driesenj/drum-machine-sequencer/README.md

# STM32 Drum Sequencer

A 15-channel hardware step sequencer built around the STM32L476RG microcontroller. Designed for use with modular synthesizers or any gear that accepts gate signals. Features per-channel gate outputs, two pattern banks, live and commit editing modes, swing, randomisation, ratchet, and save/load to onboard flash.

---

## Features

- **15 independent gate output channels** at approximately 5V, each protected by a 1kΩ output resistor
- **8-step view window** with scrollable view across patterns up to 64 steps long
- **Two pattern banks (A/B)** per channel for quick pattern switching
- **Live mode and commit mode** — edit patterns live or stage changes and commit them all at once
- **Per-channel and global swing** (0–100%, triplet feel at maximum)
- **Per-channel and global randomisation** (0–100% gate mutation probability)
- **Ratchet** — repeat a gate 1–8 times within a single step period
- **Roll** — hold-triggered gate repeat at 1/4, 1/8, 1/16, or 1/32 subdivisions
- **Tap tempo** and per-channel custom BPM
- **Solo and mute** per channel
- **8 preset save/load slots** stored in onboard flash (non-volatile)
- **Internal and external clock** — switchable at runtime, external input protected against overvoltage
- **16×32 LED matrix** for pattern and playhead visualisation
- **128×64 OLED display** showing clock, BPM, swing, random, channel, and status information
- **Capacitive touch step buttons** with LED feedback

---

## Hardware

### Main Board

| Component | Details |
| --- | --- |
| MCU | STM32L476RG on NUCLEO-64 development board |
| Gate driver | SN74AHCT244N octal buffer, ~5V output |
| LED matrix | 2× 4-unit MAX7219 8×8 dot matrix panels (~13cm × 6.5cm each) |
| Display | SSD1306 128×64 OLED (I2C) |
| Button expander  | MCP23017 I2C GPIO expander |
| Step button LEDs | 74HC595 shift register |
| Step buttons | 8× Javino HTTM capacitive touch modules (see below) |
| Function buttons | HTTM capacitive touch modules (ALT, FILL, RECORD) |
| Encoders | 3× incremental rotary encoders with push (A, B, C) |

### Power

| Rail | Source | Powers |
| --- | --- | --- |
| 12V DC | External DC input (barrel jack) | Buck converter input |
| 5V DC  | LM2596 (or equivalent) buck converter from 12V | SN74AHCT244N, LED matrices, button LEDs, Nucleo (jumper selectable) |
| 3.3V | LM1117T regulator from 5V | MCP23017, 74HC595, SSD1306, other logic ICs |

The Nucleo board power source is selectable via jumper between 12V, 5V, and 3.3V inputs.

A ferrite bead is fitted at the 12V input to suppress switching noise from the buck converter. Analog ground and digital ground share a single star ground point.

### Clock I/O

- **External clock input**: accepts 3.3V–5V clock signals. A 1N5819 Schottky diode protection circuit guards the STM32 input against overvoltage.
- **Clock output**: 3.3V gate signal generated in internal clock mode, available for synchronising downstream gear.

### Front Panel

No enclosure is provided. The PCB includes mounting holes for a custom front panel machined from aluminium sheet or similar material and drilling holes where
buttons, knobs, outputs should go.

---

## Button Modifications

The step buttons and function buttons are of the type **HTTM capacitive touch modules** (There are multiple brands / manufacteres, this is one example: [AliExpress listing](https://nl.aliexpress.com/item/1005008287072383.html)). These require hardware modification before use.

### Step buttons (×8)

HTTM modules are latching by default and have an onboard LED resistor that must be removed to allow external LED control via the 74HC595.

Two modifications are required:

1. **Remove the LED resistor** — this disconnects the onboard LED circuit so the step LED brightness is controlled externally.
2. **Remove the latch resistor** — this converts the output from latching (toggle) to momentary. The exact resistor positions depend on the PCB revision of your modules; consult the HTTM datasheet or inspect the PCB under magnification.
3. You will need to solder a wire from the LED output pad on the PCB to the LED pad on the HTTM during assembly

After modification each button outputs a high pulse only while touched.

### FILL and RECORD buttons

These only require the **momentary modification** (remove the latch resistor). The onboard LED is not used on these buttons.

### ALT button

No modification required beyond the momentary conversion.

---

## LED Matrix

Two 4-in-1 MAX7219 dot matrix panels are used ([similar AliExpress listing](https://nl.aliexpress.com/item/1005010400568936.html)), giving a 16-row × 32-column display.

Layout:

| Row  | Content |
| ---- | --- |
| 0 | Playhead and view window indicator for the active channel |
| 1–15 | One row per sequencer channel showing active steps and playhead |

---

## Controls

### Step Buttons (S1–S8)

| Input | Action |
| --- | --- |
| S1–S8 | Toggle step 1–8 in the current channel/bank/window |
| S1 (ALT) | **ALL mode** — subsequent per-channel operations apply to all channels |
| S2 (ALT) | Clear all steps in the current channel |
| S2 (ALT+ALL) | Clear all steps in all channels |
| S3 (ALT) | Toggle Live / Commit mode |
| S4 (ALT) | Toggle Internal / External clock |
| S5–S8 (ALT)  | Roll at 1/4, 1/8, 1/16, 1/32 (held) |

### Function Buttons

| Input | Action |
| --- | --- |
| ALT | Hold to enable ALT modifier |
| FILL | Hold to trigger the current channel gate on every step |
| FILL (ALT) | Switch active bank (A↔B) on the current channel |
| FILL (ALT+ALL) | Switch active bank on all channels |
| RECORD | Trigger and record the current channel gate |
| RECORD (ALT + Commit mode) | Commit all pending changes (steps, length, BPM) |
| RECORD (ALT + Live mode) | Tap tempo |

### Encoder A — Channel / Mute / Solo

| Input | Action |
| --- | --- |
| Turn | Select channel |
| Turn (ALT) | Adjust channel randomisation amount |
| Turn (ALT+ALL)  | Adjust global randomisation amount  |
| Press | Solo / unsolo current channel |
| Press (ALT) | Mute / unmute current channel |
| Press (ALT+ALL) | Mute / unmute all channels |

### Encoder B — Length / Swing / Ratchet

| Input | Action |
| --- | --- |
| Turn | Adjust current channel length |
| Turn (ALT) | Adjust channel swing amount |
| Turn (ALT+ALL) | Adjust global swing amount |
| Turn (Ratchet mode) | Set ratchet count on held step button(s) |
| Press | Enter / exit Ratchet mode |
| Press (ALT) | Reset current channel to transport position |
| Press (ALT+ALL) | Reset all channels to transport position |

### Encoder C — Window / BPM / Save-Load

| Input | Action |
| --- | --- |
| Turn | Scroll view window |
| Turn (ALT) | Adjust channel BPM |
| Turn (ALT+ALL) | Adjust global BPM |
| Turn (Save/Load menu)  | Scroll through menu items |
| Press | Open Save/Load menu |
| Press (Save/Load menu) | Confirm selected menu item |
| Press (ALT) | Reset current channel settings (BPM, swing, rand) |
| Press (ALT+ALL) | Reset settings on all channels |

---

## OLED Display

The 128×64 display shows six lines of information:

```
[INT:120 ]    [LIVE]
RAND: 0%   SWING: 0%
──────────────────────
CHAN:01-A      LEN:16
RAND: 0%   SWING: 0%
BPM:120        [SOLO]
```

- **Line 0**: Clock source (INT/EXT), BPM, pending-change indicator (`*`), and mode (LIVE / COMMIT / RTCH)
- **Line 1**: Global randomisation and swing percentages
- **Line 2**: Current channel number, active bank (A/B), and pattern length
- **Line 3**: Per-channel randomisation and swing percentages
- **Line 4**: Effective channel BPM, pending indicator, and mute/solo status

---

## Firmware

### Build environment

- STM32CubeIDE with arm-none-eabi-gcc
- HAL drivers generated by STM32CubeMX
- C11 (`-std=gnu11`) required for `_Static_assert`

### Project structure

| File | Responsibility |
| --- | --- |
| `main.c` | Hardware init, main loop orchestration |
| `sequencer.c / .h` | All sequencer logic — clock, advance, gates, presets  |
| `ui.c / .h` | Input event queue, dispatcher, display and LED render |
| `flash.c / .h` | Preset serialisation to internal flash |
| `utils.h` | Shared `CLAMP` macro |
| `MAX7219.c / .h` | LED matrix SPI driver |
| `MCP23017.c / .h`  | GPIO expander I2C driver with callback system |
| `74HC595.c / .h` | Shift register SPI driver |
| `SSD1306.c / .h` | OLED display I2C driver |
| `Encoder.c / .h` | Quadrature encoder driver using STM32 timer capture |

### Flash preset layout

Eight preset slots are stored in the last 32KB of the 1MB flash (address `0x080F8000`–`0x080FFFFF`). The linker script reserves this region so code is never placed there. A `_Static_assert` in `flash.c` validates the layout at compile time.

### Testability

`sequencer.c` and `ui.c` have no direct HAL dependencies beyond `HAL_GetTick()`. Hardware callbacks (clock output GPIO, flash read/write, clock mode GPIO reconfiguration) are injected as function pointers at initialisation, allowing the sequencer and dispatcher to be compiled and tested on a host machine with stub implementations.

---

## Wiring Notes

_To be completed with connector pinout diagram once PCB Gerbers are finalised._

---

## License

This project is released under the **Creative Commons Attribution-NonCommercial-ShareAlike 4.0 International (CC BY-NC-SA 4.0)** license.

You are free to use, modify, and share this project for **non-commercial purposes**, as long as you give appropriate credit and distribute any derivatives under the same license. Commercial use of the hardware design, firmware, or derivatives is not permitted without explicit written permission.

[Full license text](https://creativecommons.org/licenses/by-nc-sa/4.0/)
