driesenj/drum-machine-sequencer/SCH_Sequencer Schema_2026-04-22.pdf

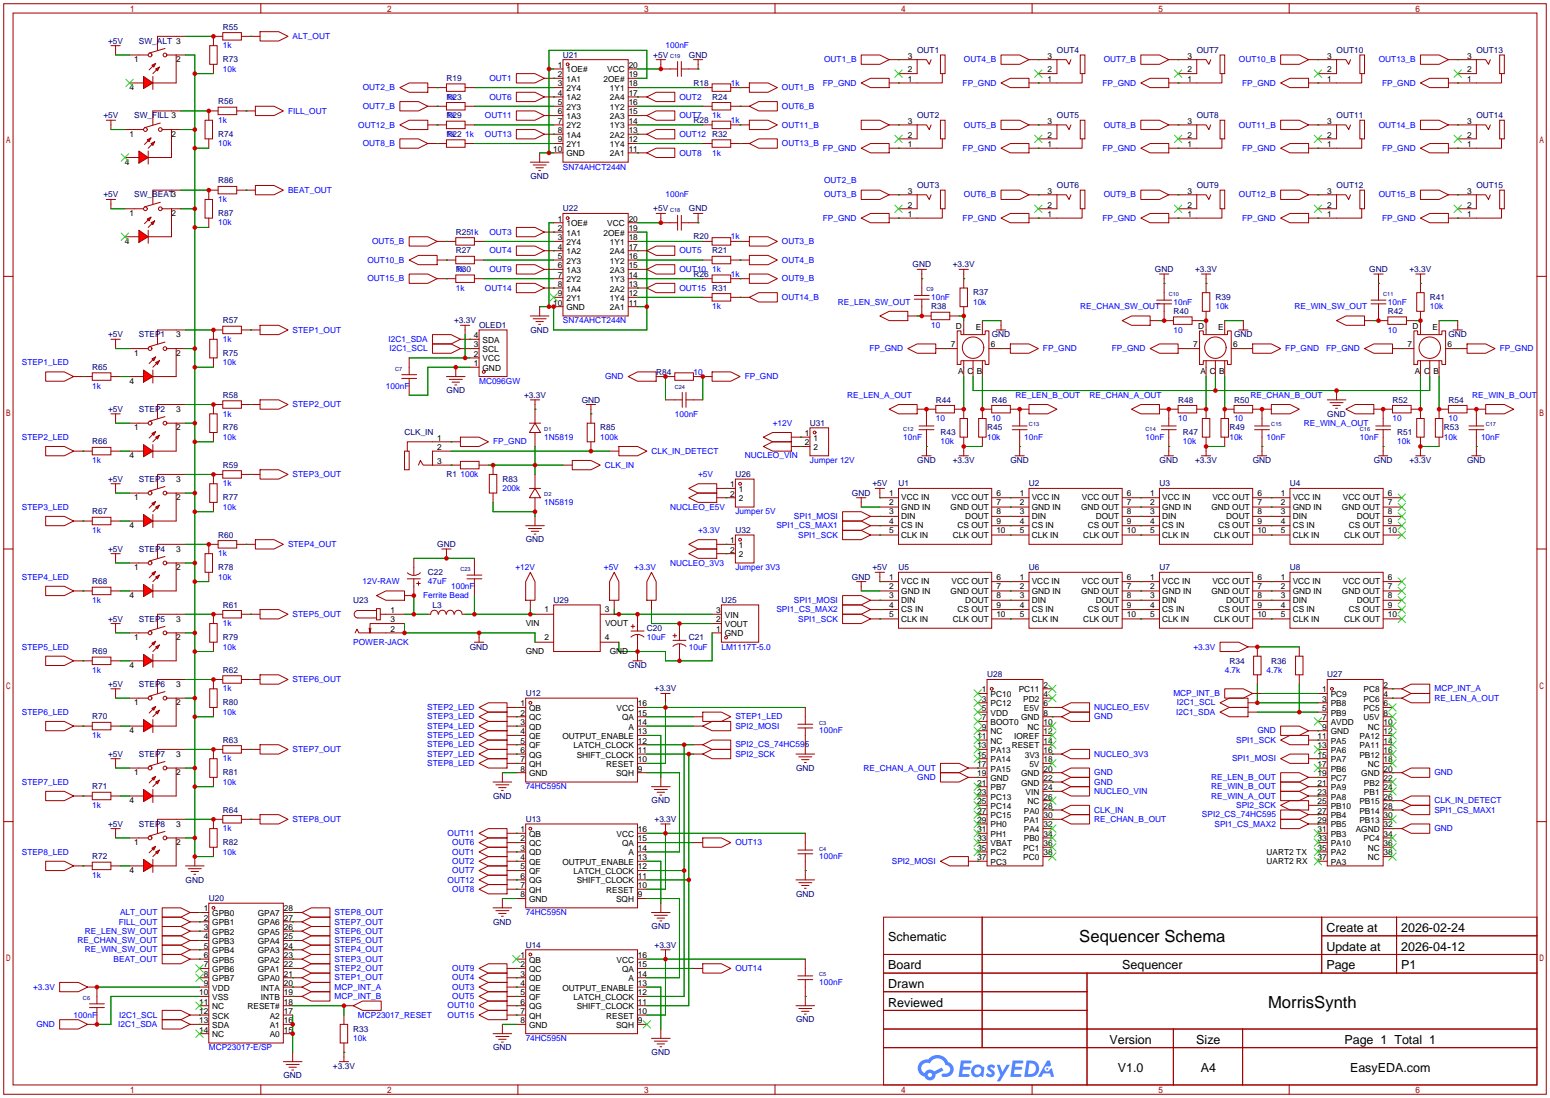
[picture p1: page 1]

Schematic | Sequencer Schema | Create at | 2026-02-24

Update at | 2026-04-12

Board | Sequencer | Page | P1
Drawn | | MorrisSynth
Reviewed

Version | Size | Page 1 Total 1
V1.0 | A4 | EasyEDA.com
