driesenj/drum-machine-sequencer/STM32IDE/DrumSequencer/Core/Src/main.c

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
/* Includes ------------------------------------------------------------------*/
#include "main.h"

/* USER CODE BEGIN Includes */
#include "stdio.h"
#include "MAX7219.h"
#include "MCP23017.h"
#include "74HC595.h"
#include "Encoder.h"
#include "SSD1306.h"
#include "sequencer.h"
#include "ui.h"
#include "utils.h"
#include "flash.h"

/* USER CODE END Includes */

/* USER CODE BEGIN PD */
#define DEBUG_LOG 1

/* USER CODE END PD */

I2C_HandleTypeDef hi2c1;

SPI_HandleTypeDef hspi1;
SPI_HandleTypeDef hspi2;

TIM_HandleTypeDef htim1;
TIM_HandleTypeDef htim2;
TIM_HandleTypeDef htim3;
TIM_HandleTypeDef htim6;

UART_HandleTypeDef huart2;

/* USER CODE BEGIN PV */

// ── External Clock Input  ──────────────────────────────────────────────────────────────
volatile uint8_t clock_tick = 0;  // set by ISR, consumed by main loop

// ── UI ─────────────────────────────────────────────────────────────
UIContext_t ui_ctx;

// ── Encoders ──────────────────────────────────────────────────────────────
// A = channel select  → TIM2
// B = channel length  → TIM3
// C = view window     → TIM1
Encoder_t *encA;
Encoder_t *encB;
Encoder_t *encC;

// Last known counts — used to compute delta each loop tick
static int16_t last_cnt_A = 0;
static int16_t last_cnt_B = 0;
static int16_t last_cnt_C = 0;

// ── Sequencer ─────────────────────────────────────────────────────────────
Sequencer_t seq;

// ── MCP ───────────────────────────────────────────────────────────────────
MCP23017_Handle mcp;
/* USER CODE END PV */

void SystemClock_Config(void);
static void MX_GPIO_Init(void);
static void MX_SPI1_Init(void);
static void MX_I2C1_Init(void);
static void MX_USART2_UART_Init(void);
static void MX_TIM3_Init(void);
static void MX_SPI2_Init(void);
static void MX_TIM1_Init(void);
static void MX_TIM2_Init(void);
static void MX_TIM6_Init(void);
/* USER CODE BEGIN PFP */
#define PUTCHAR_PROTOTYPE int __io_putchar(int ch)
/* USER CODE END PFP */

/* USER CODE BEGIN 0 */

static void apply_clock_mode_impl(uint8_t clock_mode) {
    GPIO_InitTypeDef g = {
        .Pin   = CLK_IN_Pin,
        .Pull  = GPIO_NOPULL,
        .Speed = GPIO_SPEED_FREQ_LOW,
    };
    if (clock_mode == 1) {
        g.Mode = GPIO_MODE_OUTPUT_PP;
        HAL_GPIO_Init(CLK_IN_GPIO_Port, &g);
        HAL_NVIC_DisableIRQ(EXTI0_IRQn);
    } else {
        g.Mode = GPIO_MODE_IT_RISING;
        HAL_GPIO_Init(CLK_IN_GPIO_Port, &g);
        HAL_NVIC_EnableIRQ(EXTI0_IRQn);
    }
}

static void clock_output(uint8_t high) {
	HAL_GPIO_WritePin(CLK_IN_GPIO_Port, CLK_IN_Pin, high);
}

static UIFlashResult_t flash_write_impl(uint8_t slot, const SeqPreset_t *preset) {
    return Flash_WritePreset(slot, preset) == HAL_OK ? UI_FLASH_OK : UI_FLASH_ERR;
}
static void flash_read_impl(uint8_t slot, SeqPreset_t *preset) {
    Flash_ReadPreset(slot, preset);
}
static uint8_t flash_valid_impl(uint8_t slot) {
    return Flash_SlotValid(slot);
}

// ── MCP23017 button callback ───────────────────────────────────────────────
static void OnStepButton(MCP23017_Port port, MCP23017_Pin pin, uint8_t state) {
	if (port != MCP23017_PORT_A || pin >= 8) return;

	uint32_t now = HAL_GetTick();

	UIQueue_Push((UIEvent_t){
		.tick_ms = now,
		.type  = state ? EVT_STEP_PRESS : EVT_STEP_RELEASE,
		.value = pin
	});
}

static void OnFunctionButton(MCP23017_Port port, MCP23017_Pin pin, uint8_t state) {
	if (port != MCP23017_PORT_B) return;

	uint32_t now = HAL_GetTick();

	switch (pin) {
	case 0:
		UIQueue_Push((UIEvent_t){
			.tick_ms = now,
			.type = state ? EVT_ALT_PRESS : EVT_ALT_RELEASE
		});
		break;
	case 1:
		UIQueue_Push((UIEvent_t){
			.tick_ms = now,
					.type = state ? EVT_FILL_PRESS : EVT_FILL_RELEASE
		});
		break;
	case 5:
		UIQueue_Push((UIEvent_t){
			.tick_ms = now,
					.type = state ? EVT_RECORD_PRESS : EVT_RECORD_RELEASE
		});
		break;
	case 2: if (state == 1) UIQueue_Push((UIEvent_t){ .tick_ms = now, .type = EVT_ENC_B_PUSH }); break;
	case 3: if (state == 1) UIQueue_Push((UIEvent_t){ .tick_ms = now,.type = EVT_ENC_A_PUSH }); break;
	case 4: if (state == 1) UIQueue_Push((UIEvent_t){ .tick_ms = now,.type = EVT_ENC_C_PUSH }); break;
	}
}

/* USER CODE END 0 */

/**
  * @brief  The application entry point.
  * @retval int
  */
int main(void)
{

  /* MCU Configuration--------------------------------------------------------*/

  /* Reset of all peripherals, Initializes the Flash interface and the Systick. */
  HAL_Init();

  /* Configure the system clock */
  SystemClock_Config();

  /* Initialize all configured peripherals */
  MX_GPIO_Init();
  MX_SPI1_Init();
  MX_I2C1_Init();
  MX_USART2_UART_Init();
  MX_TIM3_Init();
  MX_SPI2_Init();
  MX_TIM1_Init();
  MX_TIM2_Init();
  MX_TIM6_Init();
  /* USER CODE BEGIN 2 */

	 printf("\n\n\n\n-----------------\r\nStarting\r\n-----------------\r\n");

	 // ── Sequencer ─────────────────────────────────────────────────────────
	 Seq_Init(&seq, clock_output);
	 printf("Initialized Sequencer\r\n");

	 // ── UI ─────────────────────────────────────────────────────────
	 UI_Init(&ui_ctx,
	         flash_write_impl,
	         flash_read_impl,
	         flash_valid_impl,
	         apply_clock_mode_impl);
	 printf("Initialized UI\r\n");

	 // ── Encoders ──────────────────────────────────────────────────────────
	 encA = Encoder_Add(&htim3); // Turn A = channel select
	 encB = Encoder_Add(&htim2); // Turn B = channel length
	 encC = Encoder_Add(&htim1); // Turn C = view window

	 Encoder_Start(encA);
	 Encoder_Start(encB);
	 Encoder_Start(encC);

	 last_cnt_A = Encoder_GetCount(encA);
	 last_cnt_B = Encoder_GetCount(encB);
	 last_cnt_C = Encoder_GetCount(encC);

	 printf("Initialized Encoders\r\n");

	 MAX7219_init();

	 printf("Initialized MAX7219\r\n");
	 //enc1 = Encoder_Add(&htim3);
	 //Encoder_Start(enc1);

	 MCP23017_InitHandle(&mcp, &hi2c1, 0);

	 // Step buttons → PORT_A pins 0–7
	 for (uint8_t i = 0; i < 8; i++) {
		 MCP23017_SetPinMode(&mcp,     MCP23017_PORT_A, i, MCP23017_MODE_INPUT);
		 MCP23017_SetPinCallback(&mcp, MCP23017_PORT_A, i, OnStepButton);
	 }

	 // Encoder A push button
	 MCP23017_SetPinMode(&mcp,     MCP23017_PORT_B, 3, MCP23017_MODE_INPUT);
	 MCP23017_SetPinCallback(&mcp, MCP23017_PORT_B, 3, OnFunctionButton);

	 // Encoder B push button
	 MCP23017_SetPinMode(&mcp,     MCP23017_PORT_B, 2, MCP23017_MODE_INPUT);
	 MCP23017_SetPinCallback(&mcp, MCP23017_PORT_B, 2, OnFunctionButton);

	 // Encoder C push button
	 MCP23017_SetPinMode(&mcp,     MCP23017_PORT_B, 4, MCP23017_MODE_INPUT);
	 MCP23017_SetPinCallback(&mcp, MCP23017_PORT_B, 4, OnFunctionButton);

	 // ALT Button
	 MCP23017_SetPinMode(&mcp,     MCP23017_PORT_B, 0, MCP23017_MODE_INPUT);
	 MCP23017_SetPinCallback(&mcp, MCP23017_PORT_B, 0, OnFunctionButton);

	 // FILL Button
	 MCP23017_SetPinMode(&mcp,     MCP23017_PORT_B, 1, MCP23017_MODE_INPUT);
	 MCP23017_SetPinCallback(&mcp, MCP23017_PORT_B, 1, OnFunctionButton);

	 // Record Button
	 MCP23017_SetPinMode(&mcp,     MCP23017_PORT_B, 5, MCP23017_MODE_INPUT);
	 MCP23017_SetPinCallback(&mcp, MCP23017_PORT_B, 5, OnFunctionButton);

	 printf("Initialized MCP23017\r\n");

	 HC595_init(&hspi2);
	 HC595_clear();

	 // Test: Set all button LEDs on
	 uint8_t data[HC595_NUM_DEVICES];
	 data[0] = 0xFF;
	 data[1] = 0x00;
	 data[2] = 	0x00;

	 HC595_write(data);

	 printf("Initialized 74HC595\r\n");

	 SSD1306_Init(&hi2c1);

	 // Splash screen
	 SSD1306_Fill(0);
	 printf("Initialized SSD1306\r\n");

	 seq.running = 1;

  /* USER CODE END 2 */

  /* Infinite loop */
  /* USER CODE BEGIN WHILE */
	 uint32_t prev = HAL_GetTick();
	 seq.last_clk_tick = prev;
	 while (1)
	 {
		 uint32_t now = HAL_GetTick();

		 // ── Clock ─────────────────────────────────────────────────────────
		 uint8_t clock_fired = 0;
		 if (seq.clock_mode == 1) {
			 clock_fired = Seq_TickClock(&seq, now);
		 } else if (clock_tick) {
			 clock_tick  = 0;
			 clock_fired = 1;
		 }

		 // ── Sequencer advance ─────────────────────────────────────────────
		 uint16_t ticked_mask = Seq_AdvanceAll(&seq, now, clock_fired);

		 if (ticked_mask) {
		     if (ui_ctx.fill_held && (ticked_mask & (1u << seq.current_channel)))
		         seq.channels[seq.current_channel].gate_forced = 1;
		     ui_ctx.matrix_dirty = 1;
		 }


		 // ── Roll + gate outputs ───────────────────────────────────────────
		 Seq_UpdateRoll(&seq, now);
		 Seq_UpdateGateOutputs(&seq, now);

		 // ── Input ─────────────────────────────────────────────────────────
		 if (Encoder_HasChanged(encA)) {
			 int16_t cnt = Encoder_GetCount(encA);
			 UIQueue_Push((UIEvent_t){ .tick_ms = now, .type = EVT_ENC_A_TURN, .value = cnt - last_cnt_A });
			 last_cnt_A = cnt;
		 }

		 // ── Encoder B ─────────────────────────────────────────────────────────
		 if (Encoder_HasChanged(encB)) {
			 int16_t cnt = Encoder_GetCount(encB);
			 UIQueue_Push((UIEvent_t){ .tick_ms = now, .type = EVT_ENC_B_TURN, .value = cnt - last_cnt_B });
			 last_cnt_B = cnt;
		 }

		 // ── Encoder C ─────────────────────────────────────────────────────────
		 if (Encoder_HasChanged(encC)) {
			 int16_t cnt = Encoder_GetCount(encC);
			 UIQueue_Push((UIEvent_t){ .tick_ms = now, .type = EVT_ENC_C_TURN, .value = cnt - last_cnt_C });
			 last_cnt_C = cnt;
		 }

		 MCP23017_Poll(&mcp);

		 UIEvent_t evt;
		 while (UIQueue_Pop(&evt)) {
			 UI_Dispatch(&ui_ctx, &seq, &evt);
		 }

		 // ── Display ───────────────────────────────────────────────────────
		 static uint32_t last_ui_update_ms = 0;

		 if (ui_ctx.stepleds_dirty) {
			 UI_UpdateStepLEDs(&ui_ctx, &seq);
			 ui_ctx.stepleds_dirty = 0;
		 }

		 // Only update the display if more than 40ms remaining until next clock tick
		 // Display update takes around 31ms
		 uint32_t next_tick_ms = Seq_NextTickMs(&seq, now);

		 if (ui_ctx.display_dirty && (next_tick_ms > now) && (next_tick_ms - now) >= 40) {
			 UI_UpdateDisplay(&ui_ctx, &seq);
			 ui_ctx.display_dirty = 0;
			 last_ui_update_ms = now;
		 }

		 if (prev < ui_ctx.channel_flash_until_ms && now > ui_ctx.channel_flash_until_ms) {
			 ui_ctx.matrix_dirty = 1;
			 ui_ctx.channel_flash_until_ms = 0;
		 }
		 if (prev < ui_ctx.length_flash_until_ms && now > ui_ctx.length_flash_until_ms) {
			 ui_ctx.matrix_dirty = 1;
			 ui_ctx.length_flash_until_ms = 0;
		 }

		 if (ui_ctx.matrix_dirty && (now - last_ui_update_ms) >= 10) {
			 UI_UpdateMatrix(&ui_ctx, &seq);
			 ui_ctx.matrix_dirty = 0;
			 last_ui_update_ms = now;
		 }

		 prev = now;
    /* USER CODE END WHILE */

    /* USER CODE BEGIN 3 */
	 }
  /* USER CODE END 3 */
}

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
/* USER CODE BEGIN 4 */

 /**
  * @brief  Retargets the C library printf function to the USART.
  *   None
  * @retval None
  */
 PUTCHAR_PROTOTYPE
 {
#if DEBUG_LOG
	 /* Place your implementation of fputc here */
	 /* e.g. write a character to the USART1 and Loop until the end of transmission */
	 HAL_UART_Transmit(&huart2, (uint8_t *)&ch, 1, 0xFFFF);
#endif
	 return ch;
 }

 void HAL_GPIO_EXTI_Callback(uint16_t GPIO_Pin)
 {
	 if (GPIO_Pin == CLK_IN_Pin) {
		 clock_tick = 1;
	 }
 }

/* USER CODE END 4 */
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
