driesenj/drum-machine-sequencer/STM32IDE/DrumSequencer/DrumSequencer.ioc

Mcu.UserName=STM32L476RGTx
PA0.GPIO_Label=CLK_IN
PA0.Signal=GPXTI0
PA1.GPIO_Label=RE_CHAN_B_OUT
PA1.Signal=S_TIM2_CH2
PA2.Signal=USART2_TX
PA3.Signal=USART2_RX
PA5.Signal=SPI1_SCK
PA7.Signal=SPI1_MOSI
PA8.GPIO_Label=RE_WIN_A_OUT
PA8.Signal=S_TIM1_CH1
PA9.GPIO_Label=RE_WIN_B_OUT
PA9.Signal=S_TIM1_CH2
PB10.Signal=SPI2_SCK
PB14.GPIO_Label=SPI1_CS_MAX1
PB14.Signal=GPIO_Output
PB15.GPIO_Label=CLK_IN_DETECT
PB15.Signal=GPIO_Output
PB5.GPIO_Label=SPI1_CS_MAX2
PB5.Signal=GPIO_Output
PB8.Signal=I2C1_SCL
PB9.Signal=I2C1_SDA
PC3.Signal=SPI2_MOSI
PC6.GPIO_Label=RE_LEN_A_OUT
PC6.Signal=S_TIM3_CH1
PC7.GPIO_Label=RE_LEN_B_OUT
PC7.Signal=S_TIM3_CH2
PC8.GPIO_Label=MCP_INT_A
PC8.Signal=GPXTI8
PC9.GPIO_Label=MCP_INT_B
PC9.Signal=GPXTI9
