driesenj/drum-machine-sequencer/STM32IDE/DrumSequencer/Core/Inc/main.h

#define CLK_IN_Pin GPIO_PIN_0
#define CLK_IN_GPIO_Port GPIOA
#define CLK_IN_EXTI_IRQn EXTI0_IRQn
#define RE_CHAN_B_OUT_Pin GPIO_PIN_1
#define RE_CHAN_B_OUT_GPIO_Port GPIOA
#define SPI1_CS_MAX1_Pin GPIO_PIN_14
#define SPI1_CS_MAX1_GPIO_Port GPIOB
#define CLK_IN_DETECT_Pin GPIO_PIN_15
#define CLK_IN_DETECT_GPIO_Port GPIOB
#define RE_LEN_A_OUT_Pin GPIO_PIN_6
#define RE_LEN_A_OUT_GPIO_Port GPIOC
#define RE_LEN_B_OUT_Pin GPIO_PIN_7
#define RE_LEN_B_OUT_GPIO_Port GPIOC
#define MCP_INT_A_Pin GPIO_PIN_8
#define MCP_INT_A_GPIO_Port GPIOC
#define MCP_INT_A_EXTI_IRQn EXTI9_5_IRQn
#define MCP_INT_B_Pin GPIO_PIN_9
#define MCP_INT_B_GPIO_Port GPIOC
#define MCP_INT_B_EXTI_IRQn EXTI9_5_IRQn
#define RE_WIN_A_OUT_Pin GPIO_PIN_8
#define RE_WIN_A_OUT_GPIO_Port GPIOA
#define RE_WIN_B_OUT_Pin GPIO_PIN_9
#define RE_WIN_B_OUT_GPIO_Port GPIOA
#define RE_CHAN_A_OUT_Pin GPIO_PIN_15
#define RE_CHAN_A_OUT_GPIO_Port GPIOA
#define SPI2_CS_74HC595_Pin GPIO_PIN_4
#define SPI2_CS_74HC595_GPIO_Port GPIOB
#define SPI1_CS_MAX2_Pin GPIO_PIN_5
#define SPI1_CS_MAX2_GPIO_Port GPIOB
